Jimenez147/Proyecto_Final/Presentacion preliminar.pdf

# SMART GAS LEAKAGE

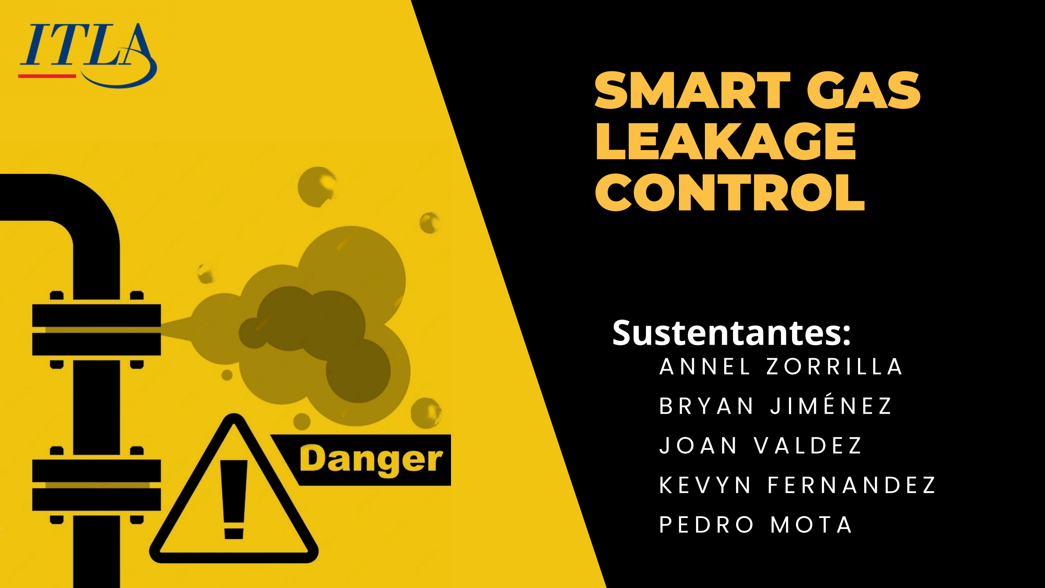
[picture p14: page 1]

# CONTROL

# A N N E L Z O R R I L L A B R Y A N J I M É N E Z J O A N V A L D E Z K E V Y N F E R N A N D E Z P E D R O M O T A

# Sustentantes:

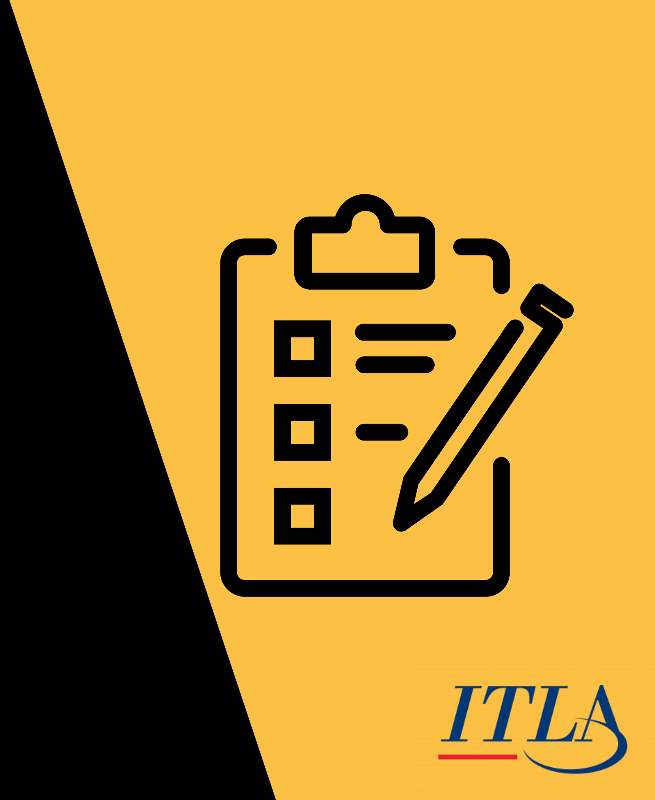
[picture p15: figure]

### 01 Descripción de Propuesta

### 02 El Equipo

### 03 Diseño Preliminar

### 04 Cronograma del Proyecto

### 05 Métodos de Prueba

### 06 Bill Of Materials

### 07 BenchMarking

# CONTENIDO

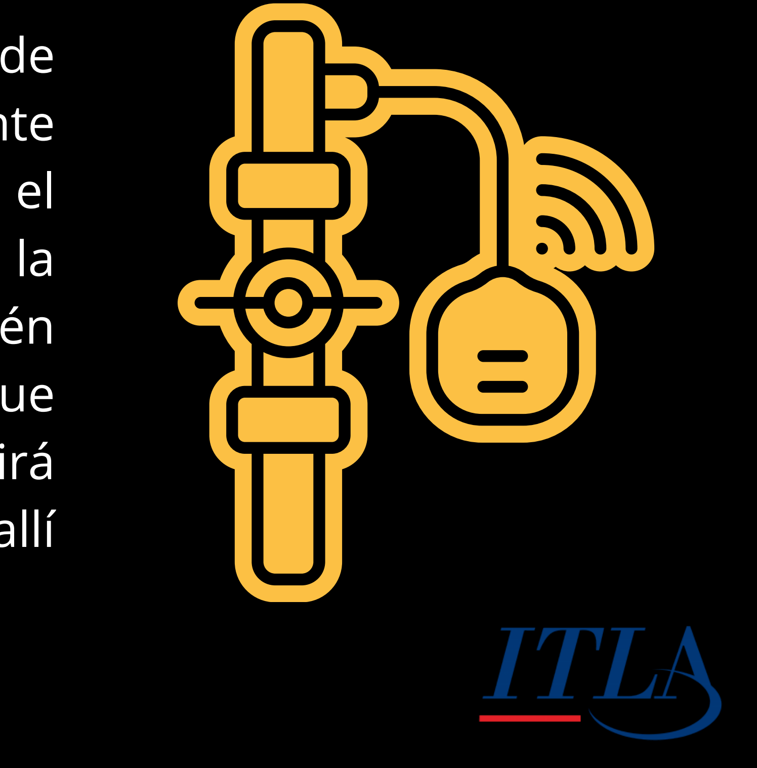
[picture p16: figure]

Este producto se trata de la integración de una alarma de gas y una válvula inteligente conectadas mediante wifi para permitir el corte del flujo de gas al momento de la detección de una fuga. El sistema también contará con una aplicación móvil que notificará al usuario sobre la fuga y permitirá una manipulación del flujo de gas desde allí

mismo.

# Descripción de la Propuesta

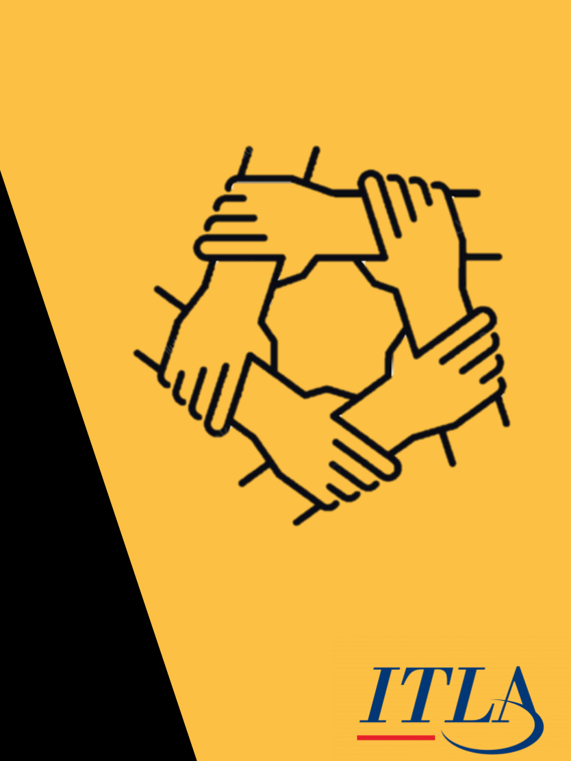
[picture p17: figure]

## * Bryan Jimenez

## Diseño del Case & PCB

*

## Pedro Mota Annel Zorrilla Joan Valdez

## Programación de Microcontroladores

## * Kevyn Fernandez

## Desarrollo de Aplicaciones

# Tareas del Equipo

# Diseño Preliminar

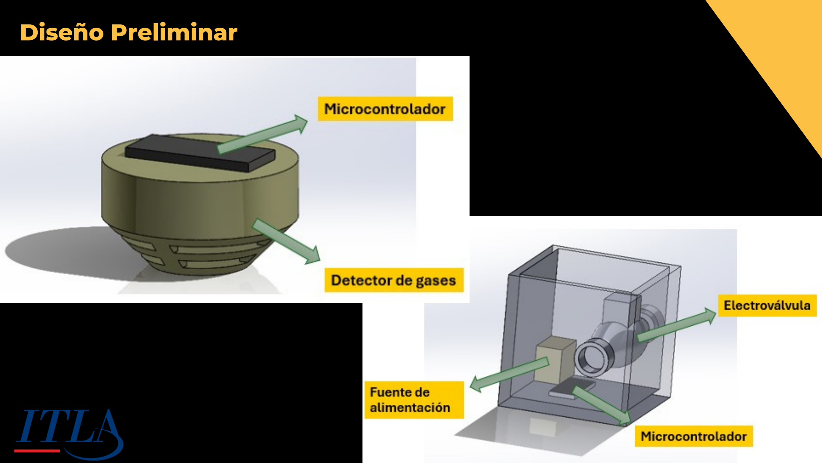
[picture p18: page 5]

Actividades | Sept | Oct | Nov | Dic
| S1 | S2 | S3 | S4 | S5 | S6 | S7 | S8 | S9 | S10 | S11 | S12 | S13 | S14

Idealizar el proyector

Presentación y aprobación del proyecto

Investigación

Compra de materiales

Diseñar prototipo

Desarrollo del sistema

Corregir errores

Verificar y últimos ajustes

Sustentación

# Cronograma

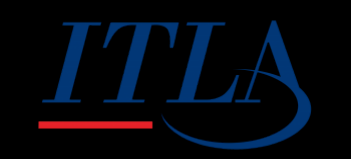
[picture p19: figure]

# Métodos de Prueba

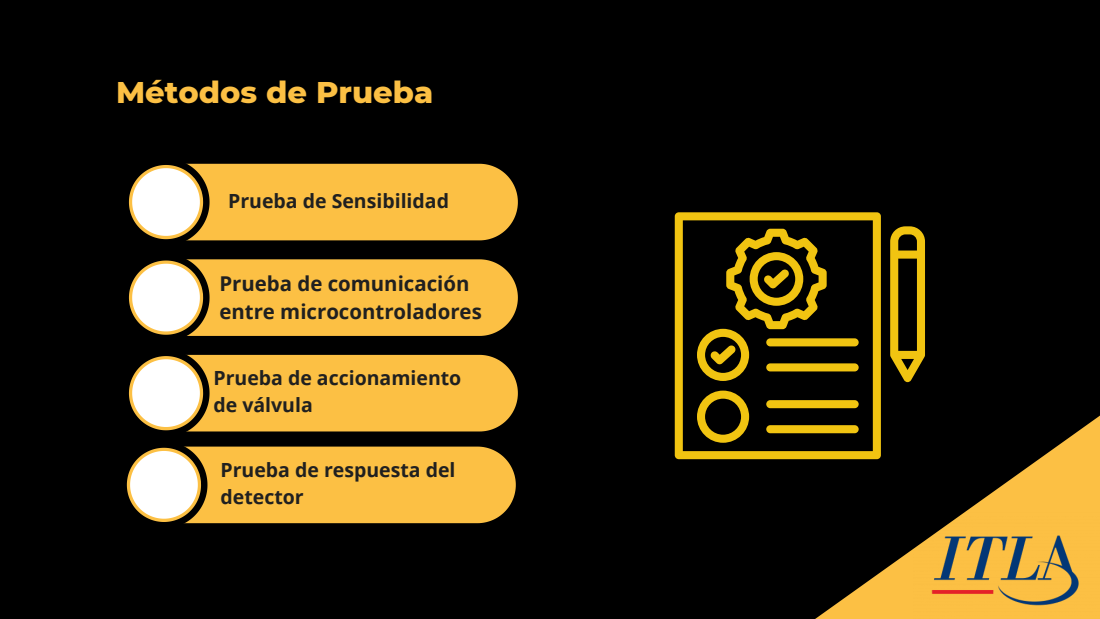
[picture p20: page 7]

Prueba de Sensibilidad

Prueba de comunicación
entre microcontroladores

Prueba de accionamiento
de válvula

Prueba de respuesta del
detector

Producto | Cantidad | Rango de precios | Descripcion

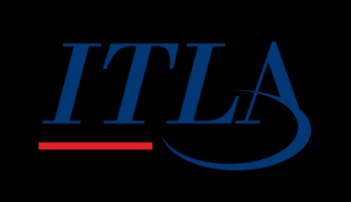
[picture p21: figure]

Microcontrolador | 2 | 2-5 USD | Uno de ellos para controlar el detector de gas y el otro para controlar la electrovalvula
Fuente de alimentacion | 2 | 1-3 USD | Para alimentar ambos microcontroladores
Encargo de PCB | 2 | 10-25 USD | Para los circuitos, tanto de la electrovalvula como del detector
Electrovalvula | 1 | 12-40 USD | Para controlar el flujo de gas
Detector de gas | 1 | 11-50 USD | Para identificar la fuga
Case | 2 | N/A | Para proteger los elementos del sistema

# Bill Of Materials

# Benchmarking

# Techamor adapta un excelente diseño

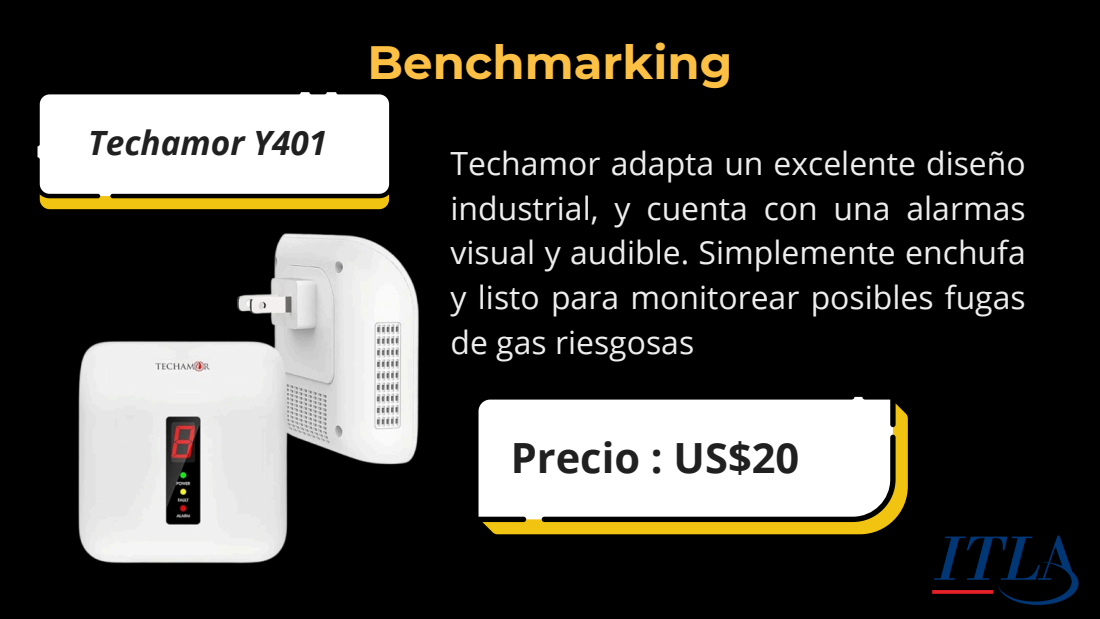
[picture p22: page 9]
Techamor Y401; Precio : US$20

industrial, y cuenta con una alarmas
visual y audible. Simplemente enchufa
y listo para monitorear posibles fugas
de gas riesgosas

# Benchmarking

# Kidde KN-COEG-3

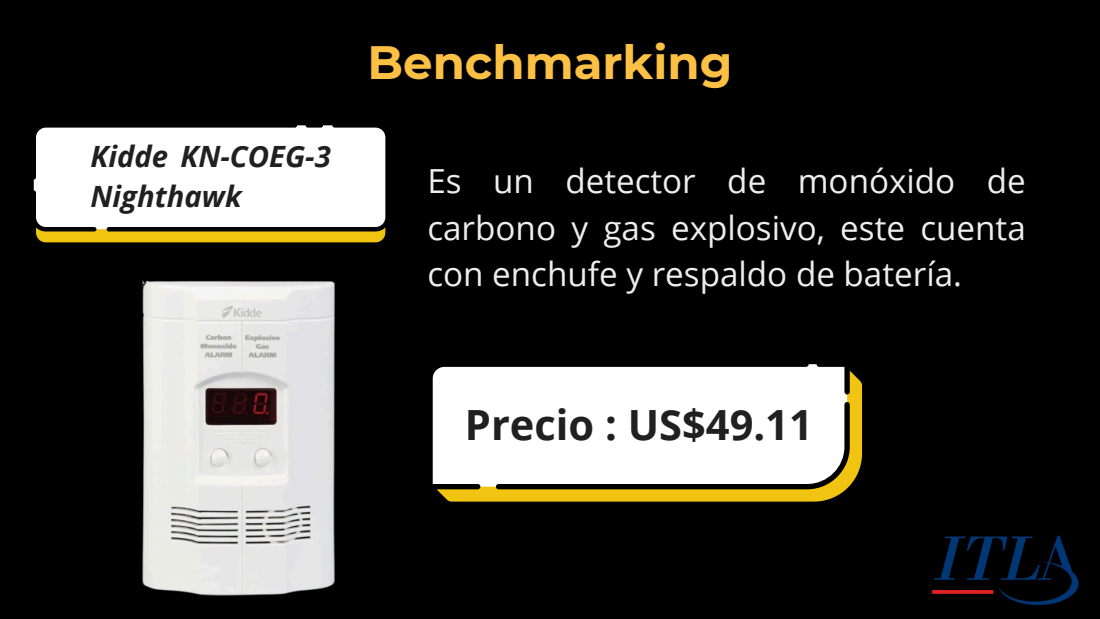
[picture p23: page 10]
Nighthawk; Precio : US$49.11

Es un detector de monóxido de
carbono y gas explosivo, este cuenta
con enchufe y respaldo de batería.

# Benchmarking

# Este es un sistema más completo el

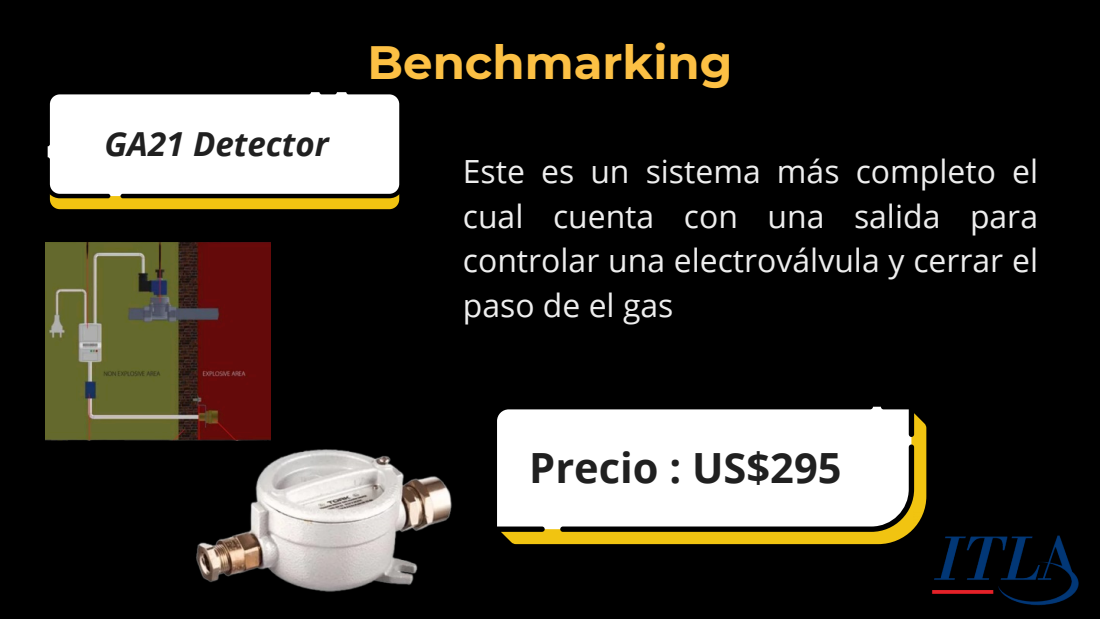
[picture p24: page 11]
Precio : US$295; GA21 Detector

cual cuenta con una salida para
controlar una electroválvula y cerrar el
paso de el gas

# ¿Qué podemos aprender de ese diseño en particular y cuales cosas pudiéramos implementar ?

# De los productos vistos anteriormente podemos tomar variedad de referencias tanto en sus diseños, como en el valor añadido de sus productos. Por ejemplo, de Kidde KN-COEG-3 podemos tomar la idea de contar con un respaldo de baterias en caso de corte electrico o de GA21 Detector la

implementacion de sus componentes.

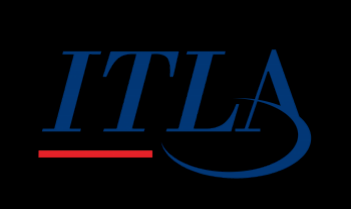
[picture p25: figure]

# INVESTIGACIONES DE EBSCO

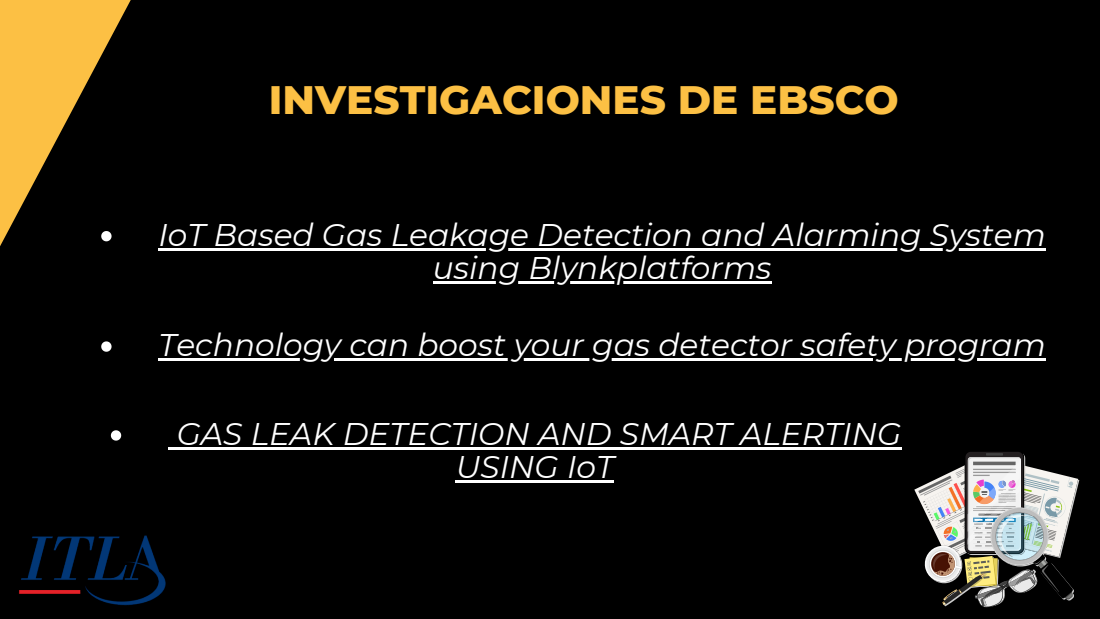
[picture p26: page 13]
using Blynkplatforms; USING IoT

IoT Based Gas Leakage Detection and Alarming System

Technology can boost your gas detector safety program (https://research.ebsco.com/c/nha4mt/search/details/x7znuuva3r?limiters=FT:Y)

GAS LEAK DETECTION AND SMART ALERTING

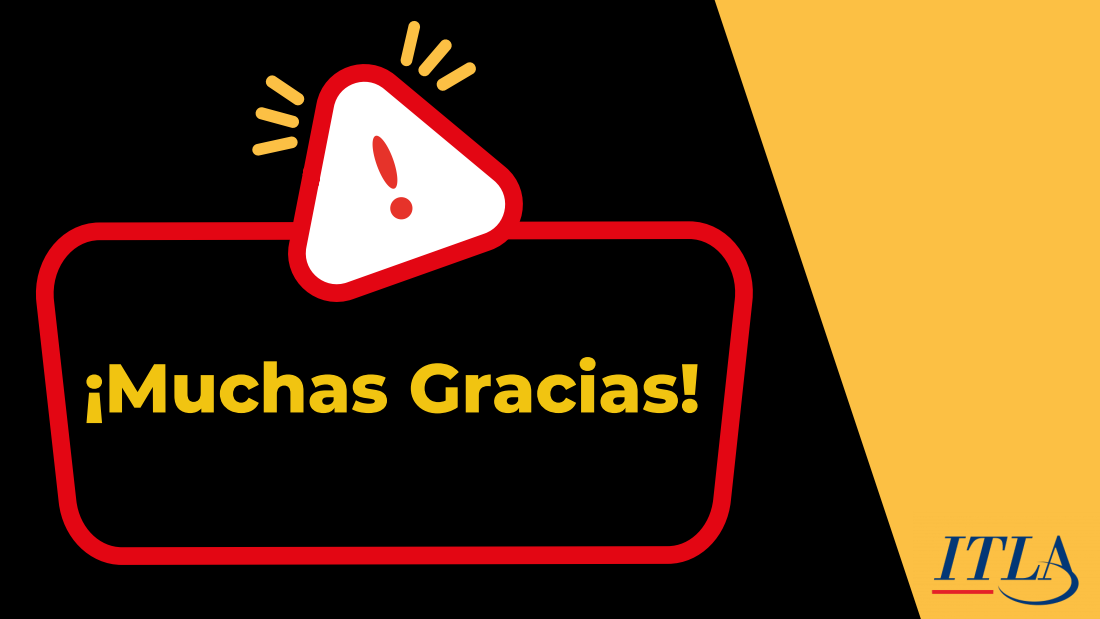
[picture p27: page 14]
¡Muchas Gracias!
