Jimenez147/Proyecto_Final/Diseño_Maestro/Detector.SLDASM

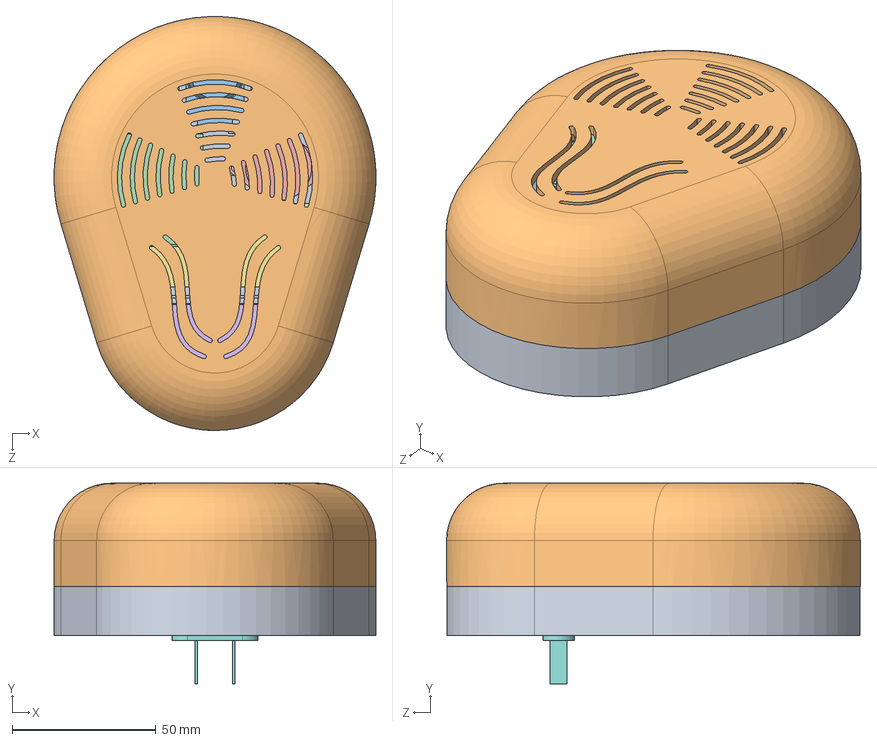
[picture p51: CAD file, 2024-12-03]
Diseño_Maestro/Detector.SLDASM
111.9 x 69.8 x 144.0 mm
Base
Sensor
transistor
Buzzer
HLK x 2
Esp
clavija
