Jimenez147/Proyecto_Final/Diseño_Esclavo/Case.SLDPRT

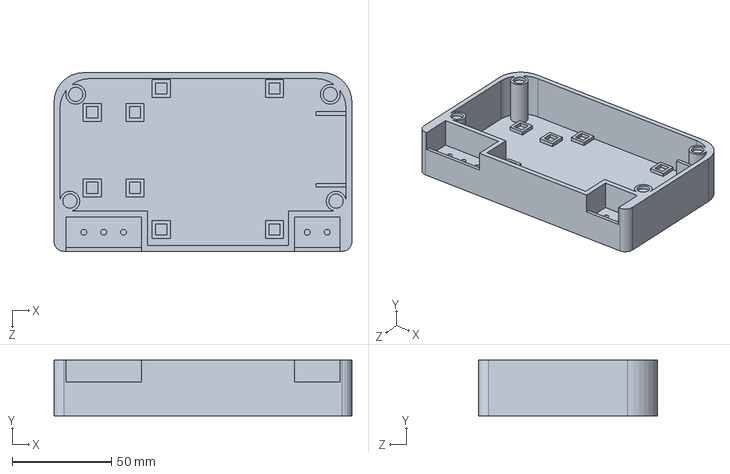
[picture p52: CAD file, 2024-12-03]
Diseño_Esclavo/Case.SLDPRT
150.0 x 28.0 x 90.0 mm
