Jimenez147/Proyecto_Final/Diseño_Maestro/HLK.SLDPRT

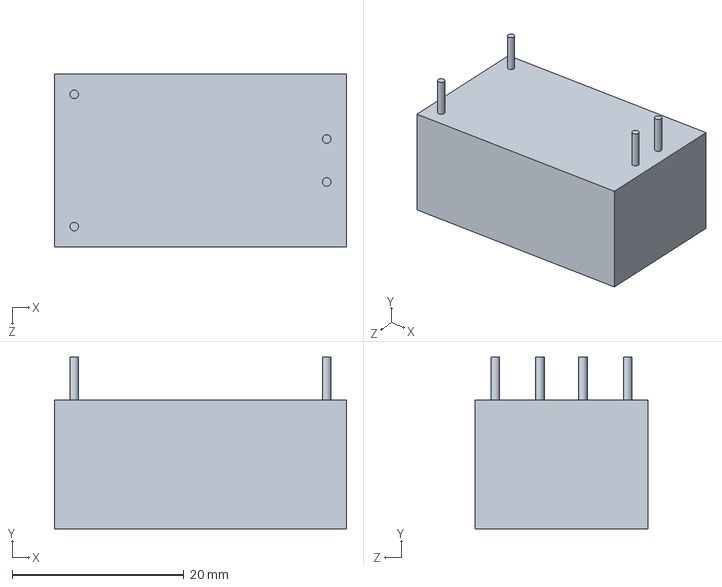
[picture p53: CAD file, 2024-12-03]
Diseño_Maestro/HLK.SLDPRT
34.0 x 20.0 x 20.2 mm
