Jimenez147/Proyecto_Final/Diseño_Esclavo/Tapa..SLDPRT

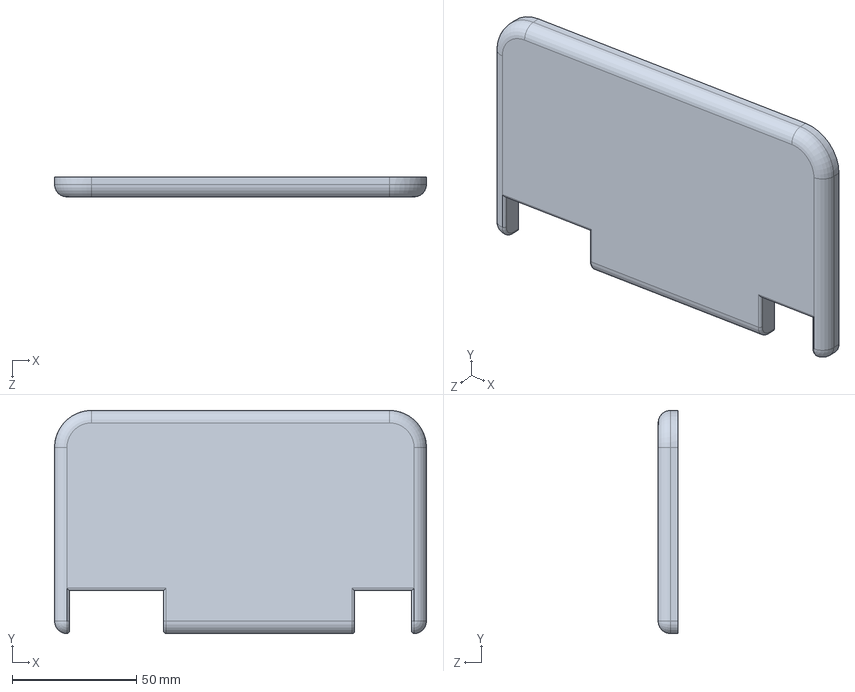
[picture p54: CAD file, 2024-12-03]
Diseño_Esclavo/Tapa..SLDPRT
150.0 x 90.0 x 8.00 mm
