Jimenez147/Proyecto_Final/Diseño_Maestro/clavija.SLDPRT

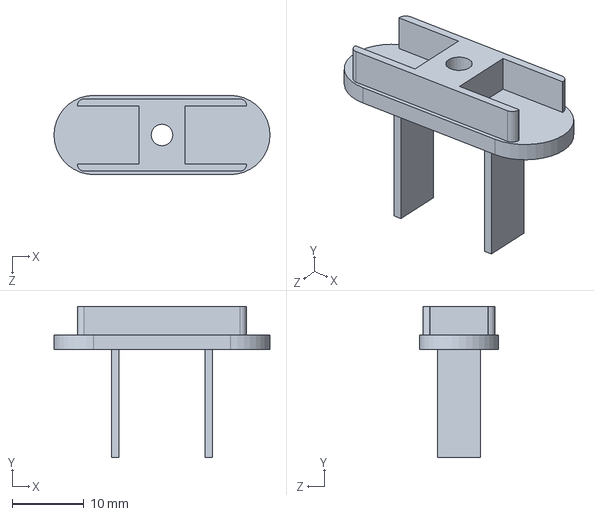
[picture p55: CAD file, 2024-12-03]
Diseño_Maestro/clavija.SLDPRT
30.0 x 21.0 x 11.0 mm
