Jimenez147/Proyecto_Final/Diseño_Maestro/Buzzer.SLDPRT

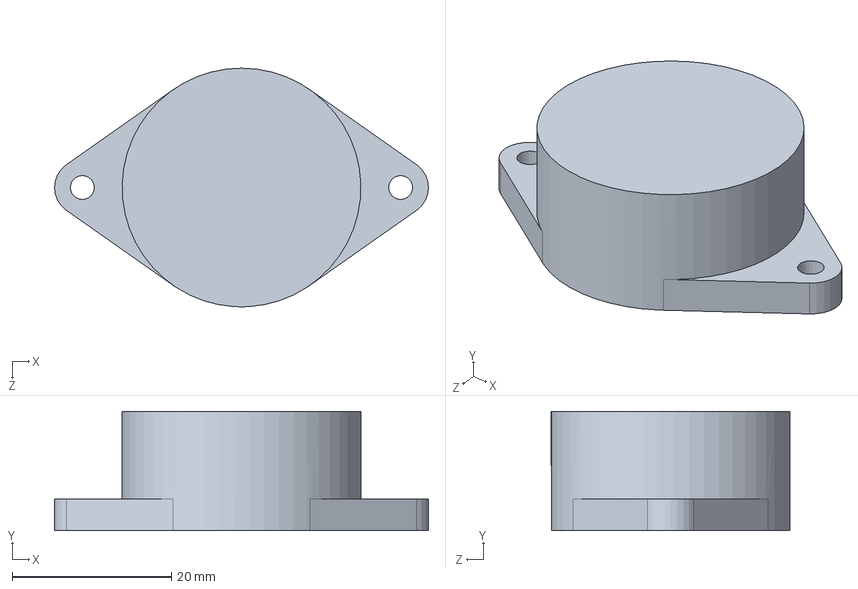
[picture p56: CAD file, 2024-12-03]
Diseño_Maestro/Buzzer.SLDPRT
47.0 x 15.0 x 30.0 mm
