Jimenez147/Proyecto_Final/Diseño_Maestro/Tapa.SLDPRT

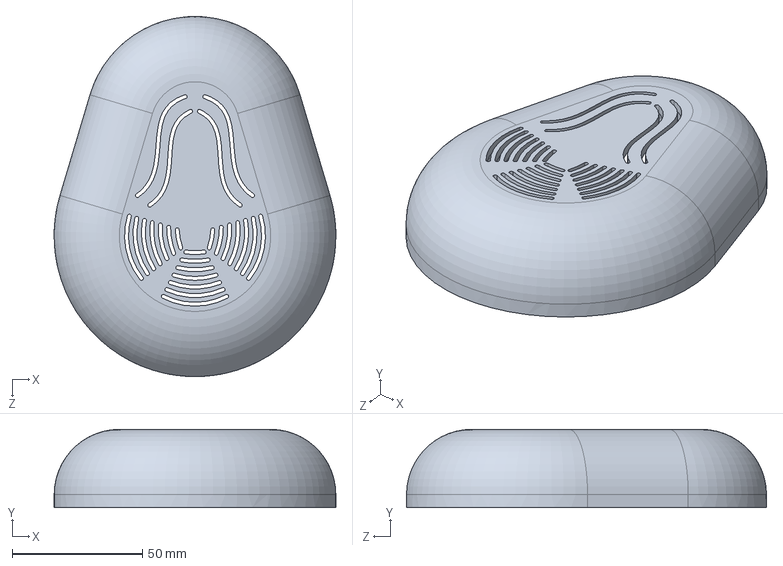
[picture p57: CAD file, 2024-12-03]
Diseño_Maestro/Tapa.SLDPRT
108.0 x 30.0 x 137.9 mm
