Jimenez147/Proyecto_Final/Diseño_Maestro/Base.SLDPRT

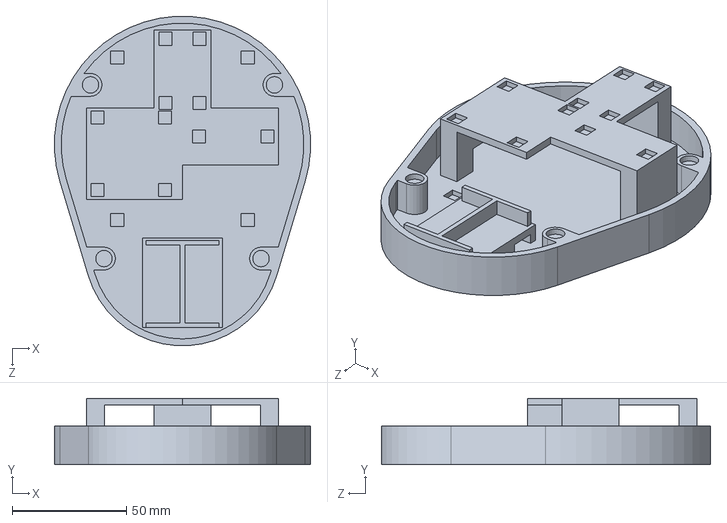
[picture p58: CAD file, 2024-12-03]
Diseño_Maestro/Base.SLDPRT
111.8 x 29.0 x 143.8 mm
