Jimenez147/Proyecto_Final/Diseño_Maestro/transistor.SLDPRT

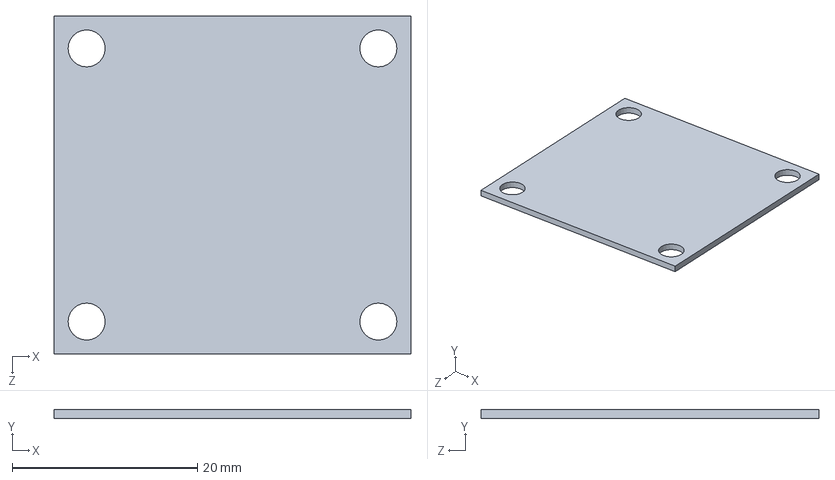
[picture p59: CAD file, 2024-12-03]
Diseño_Maestro/transistor.SLDPRT
38.5 x 1.00 x 36.5 mm
