Jimenez147/Proyecto_Final/Diseño_Maestro/Sensor.SLDPRT

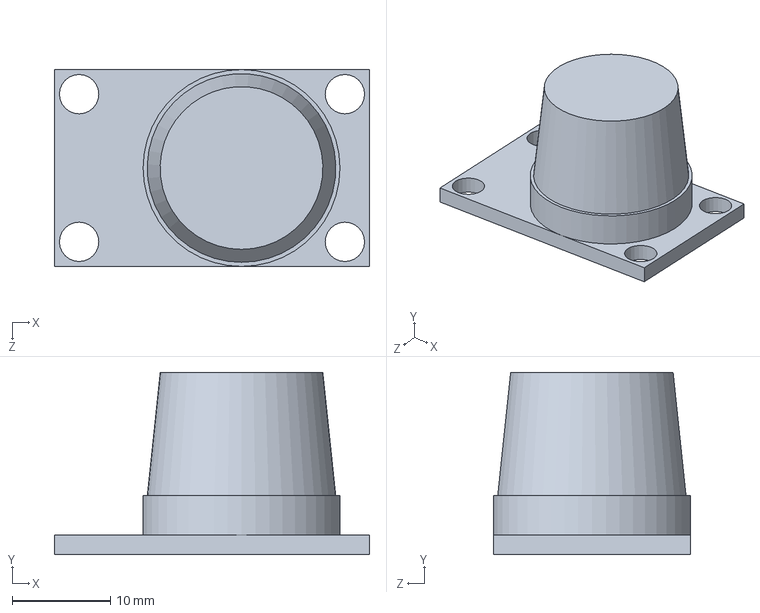
[picture p60: CAD file, 2024-12-03]
Diseño_Maestro/Sensor.SLDPRT
32.0 x 18.5 x 20.0 mm
