Jimenez147/Proyecto_Final/(list of files, cad)

Other CAD files:
Diseño_Maestro/Esp.SLDPRT
Diseño_Esclavo/Case.STL
Diseño_Esclavo/Tapa..STL
Diseño_Maestro/Base.STL
Diseño_Maestro/Tapa.STL
