Jimenez147/Proyecto_Final/Circuito_Maestro/PCB para imprimir/Impresion.pdf

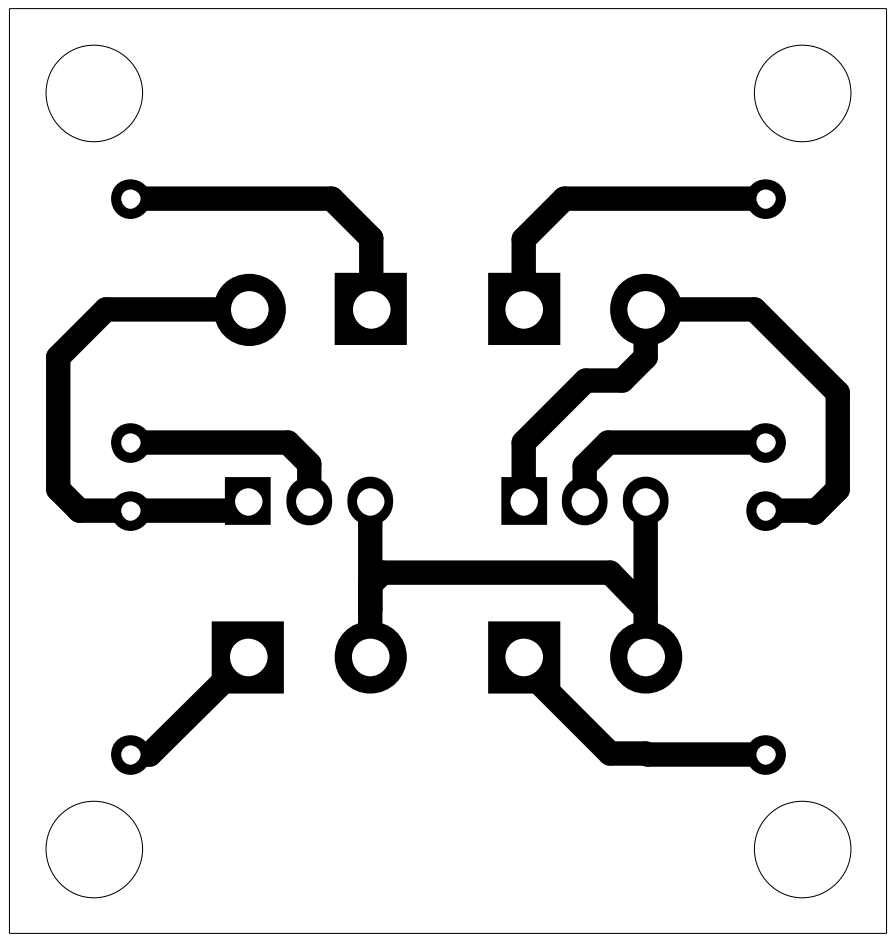
[picture p61: page 1]
