Jimenez147/Proyecto_Final/Circuito_Maestro/PCB para imprimir/PCB para imprimir.kicad_pcb

## KiCad design Circuito_Maestro/PCB para imprimir/PCB para imprimir.kicad_pcb (2024-12-03)

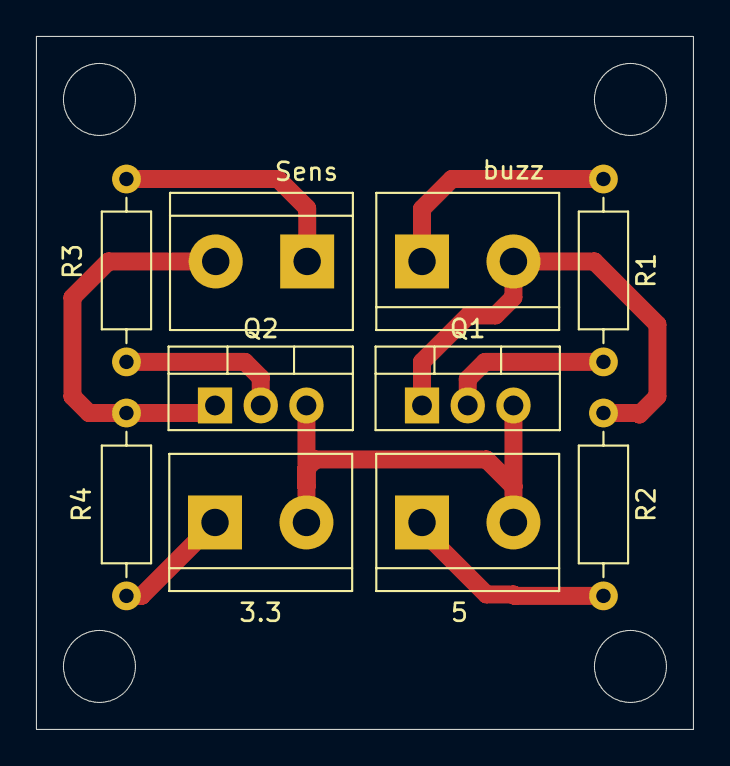
[picture p62: board PCB para imprimir.kicad_pcb from above]

Board: 2 copper layers, 36.5 x 38.5 mm, 10 parts (0 on the bottom side), 9 nets.

Parts:
3.3, 5: Conn_01x02_Pin; TerminalBlock_bornier-2_P5.08mm
Q1, Q2: NMOS; TO-220-3_Vertical
R1, R2, R3, R4: R; R_Axial_DIN0207_L6.3mm_D2.5mm_P10.16mm_Horizontal
Sens: Conn_01x02_Pin; TerminalBlock_bornier-2_P5.08mm
buzz: Conn_01x02_Pin; TerminalBlock_bornier-2_P5.08mm

Connections:
+3.3V: 3.3.1, R4.2
+5V: 5.1, R2.2
/ESP_sens: Q2.1 (D), R4.1, Sens.2
/buzz: Q1.1 (D), R2.1, buzz.2
GND: 3.3.2, 5.2, Q1.3 (S), Q2.3 (S)
unnamed: R1.1, buzz.1
unnamed: Q1.2 (G), R1.2
unnamed: Q2.2 (G), R3.2
unnamed: R3.1, Sens.1
