Jimenez147/Proyecto_Final/Circuito_Maestro/Circuito_sensor.kicad_pcb

## KiCad design Circuito_Maestro/Circuito_sensor.kicad_pcb (2024-12-03)

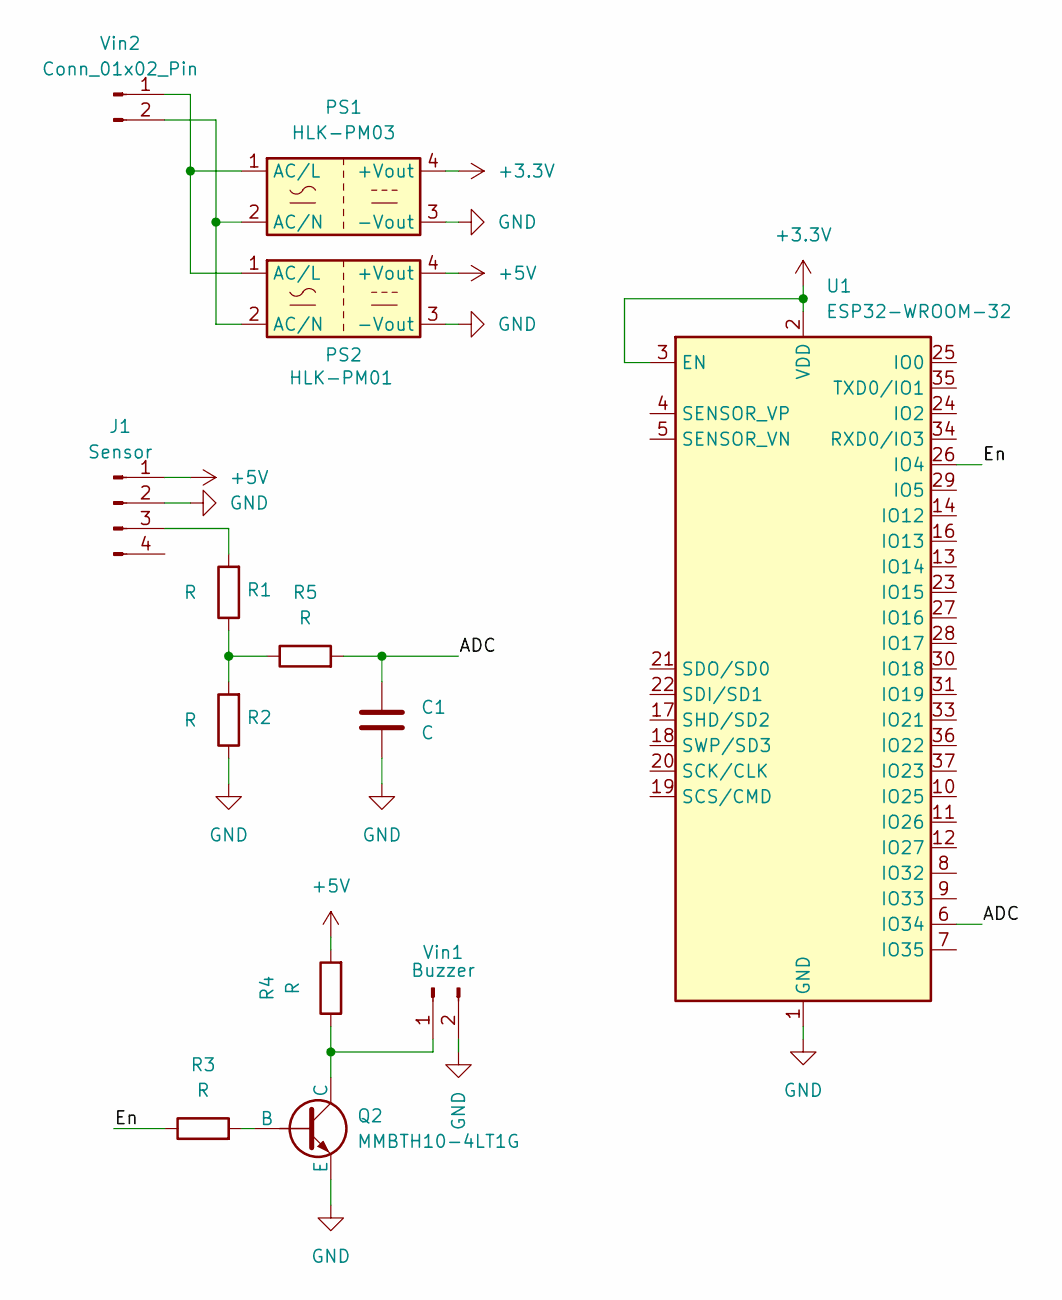
[picture p63: schematic Circuito_sensor.kicad_sch]

Parts:
C1: C; C_0201_0603Metric
J1: Sensor; PinHeader_1x04_P1.00mm_Vertical
PS1: HLK-PM03; Converter_ACDC_Hi-Link_HLK-PMxx
PS2: HLK-PM01; Converter_ACDC_Hi-Link_HLK-PMxx
Q2: MMBTH10-4LT1G; SOT-23-3
R1, R2, R3, R4, R5: R; R_0201_0603Metric
U1: ESP32-WROOM-32
Vin1: Buzzer; JST_PH_B2B-PH-K_1x02_P2.00mm_Vertical
Vin2: Conn_01x02_Pin; JST_PH_B2B-PH-K_1x02_P2.00mm_Vertical

Connections:
+3.3V: PS1.4 (+Vout), U1.2 (VDD), U1.3 (EN)
+5V: J1.1, PS2.4 (+Vout), R4.2
/ADC: C1.1, R5.2, U1.6 (IO34)
/En: R3.1, U1.26 (IO4)
GND: C1.2, J1.2, PS1.3 (-Vout), PS2.3 (-Vout), Q2.3 (E), R2.1, U1.1 (GND), U1.15 (GND), U1.38 (GND), U1.39 (GND), Vin1.2
unnamed: J1.3, R1.2
unnamed: PS1.1 (AC/L), PS2.1 (AC/L), Vin2.1
unnamed: PS1.2 (AC/N), PS2.2 (AC/N), Vin2.2
unnamed: Q2.2 (B), R3.2
unnamed: Q2.1 (C), R4.1, Vin1.1
unnamed: R1.1, R2.2, R5.1

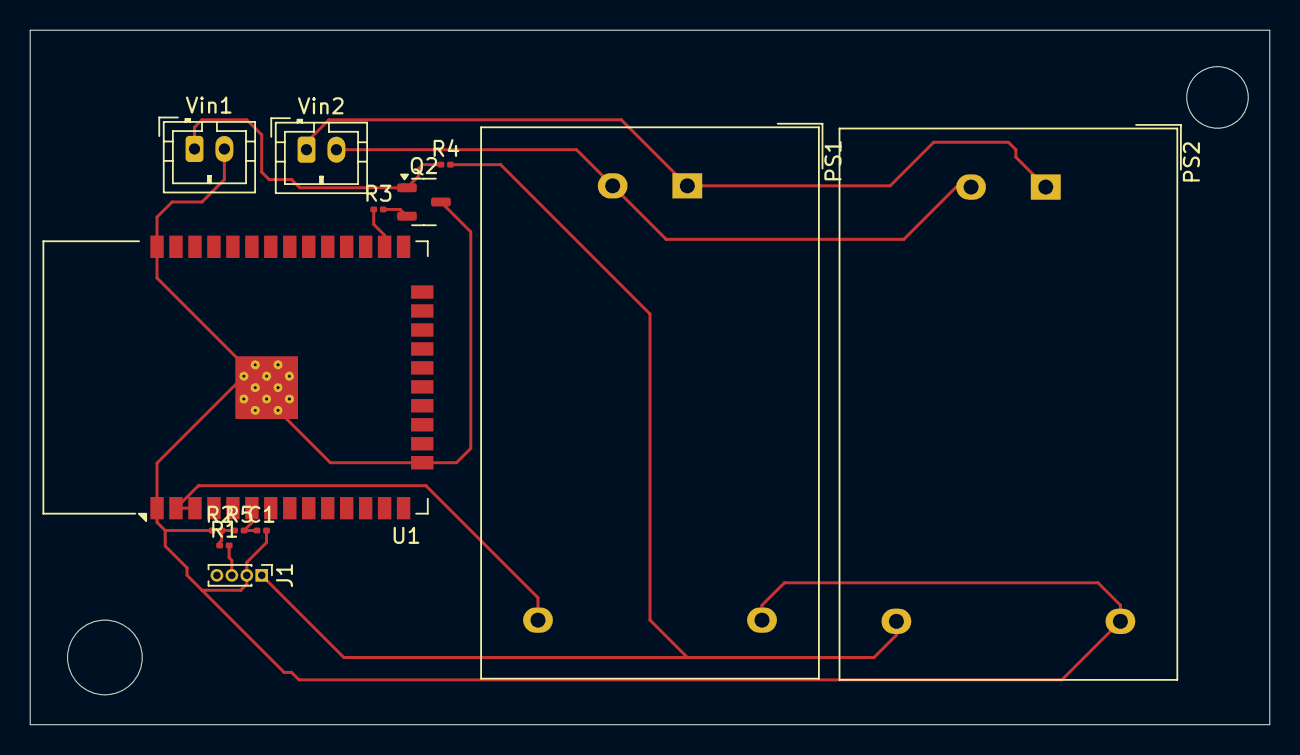
[picture p64: board Circuito_sensor.kicad_pcb from above]

Board: 2 copper layers, 83.0 x 46.5 mm, 13 parts (0 on the bottom side), 11 nets.
